painnick/BB8-2/body_mcu/README.md

# Body

## PCB

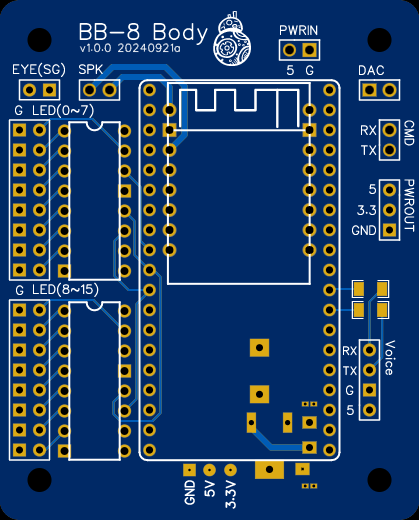
[picture p1: body_mcu/doc/body_mcu_top.png]


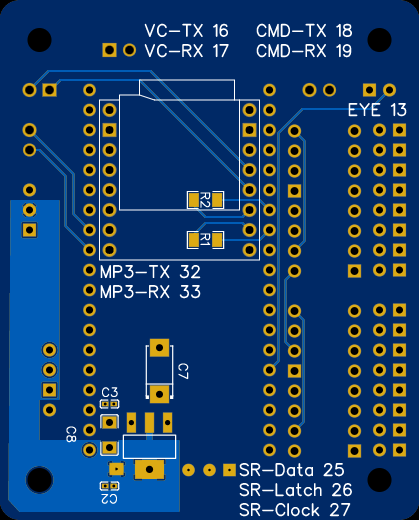
[picture p2: body_mcu/doc/body_mcu_bottom.png]


## Schematic

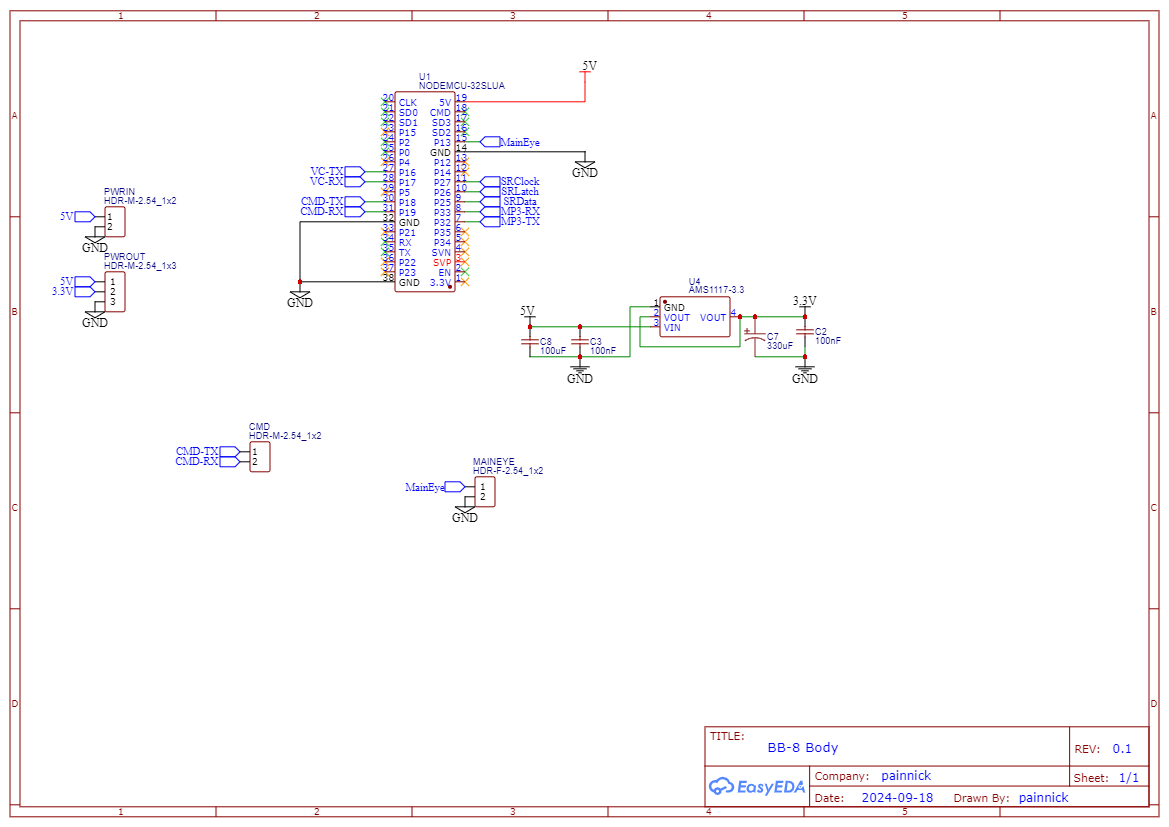
[picture p3: body_mcu/doc/Main.png]


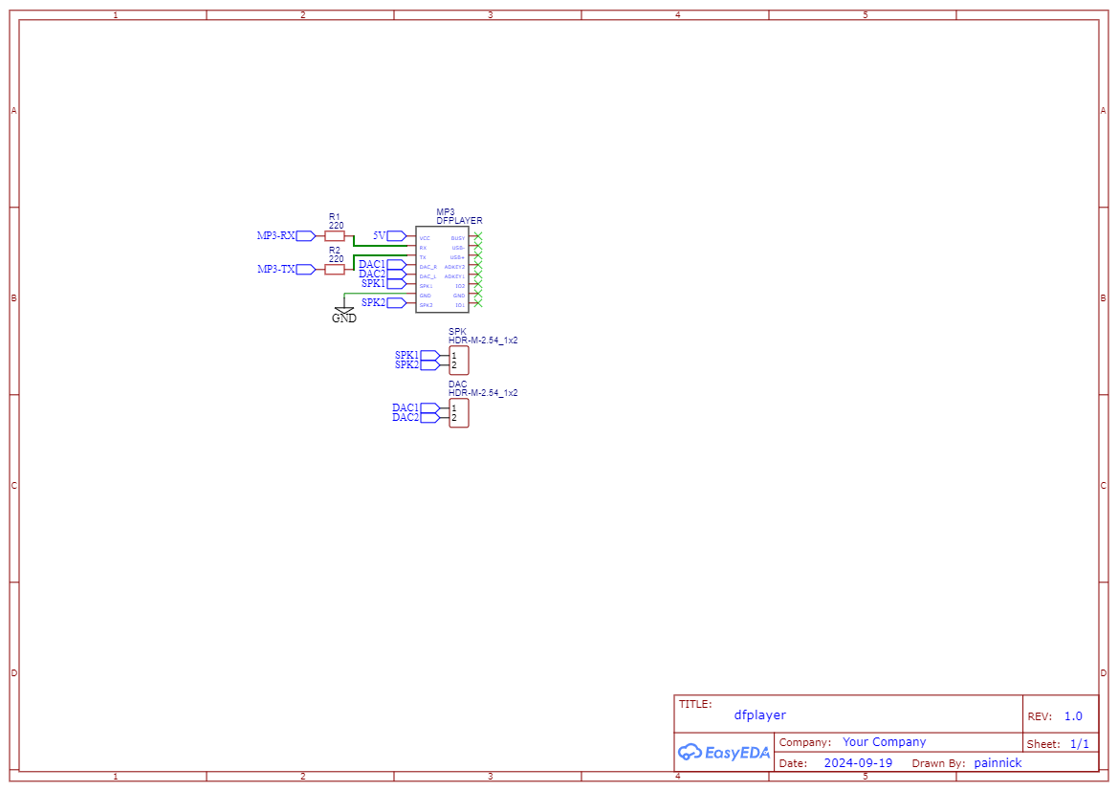
[picture p4: body_mcu/doc/dfplayer.png]


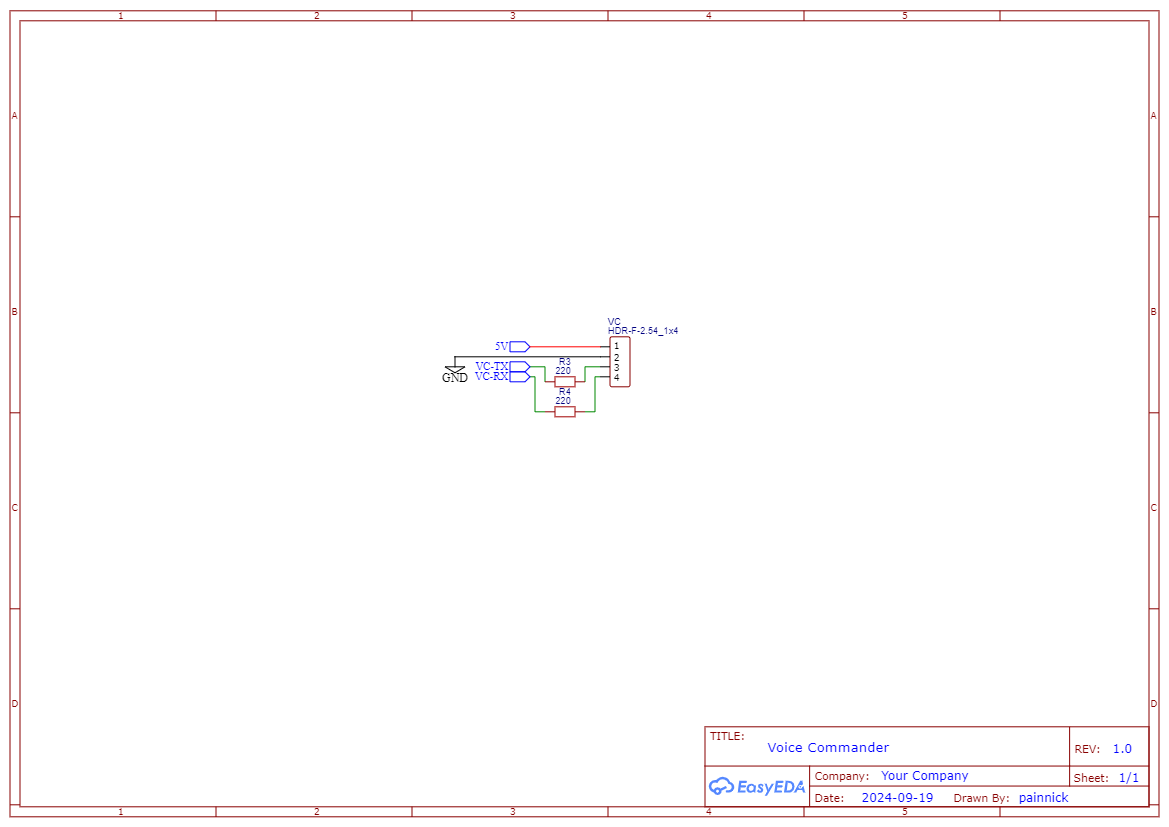
[picture p5: body_mcu/doc/VoiceCommander.png]
Voice Commander.png


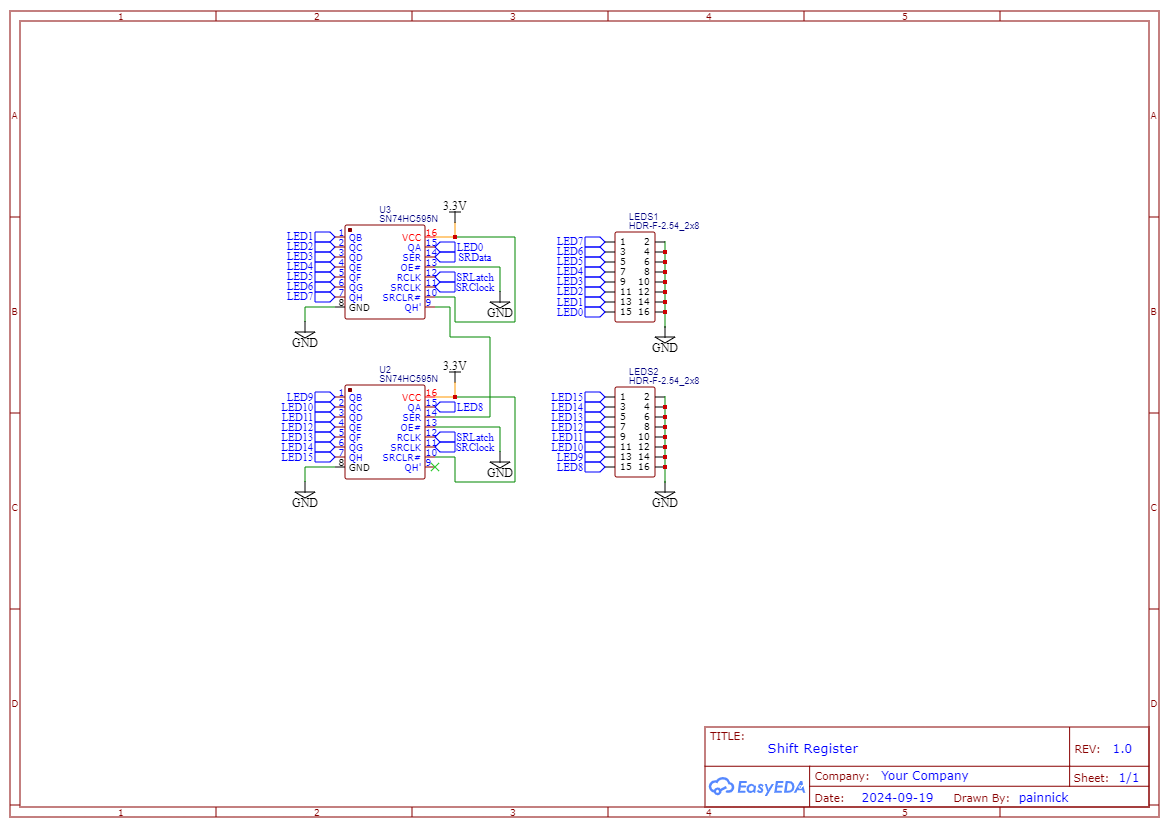
[picture p6: body_mcu/doc/ShiftRegister.png]
Shift Register.png
