painnick/BB8-2/head_mcu/README.md

# Head

## PCB

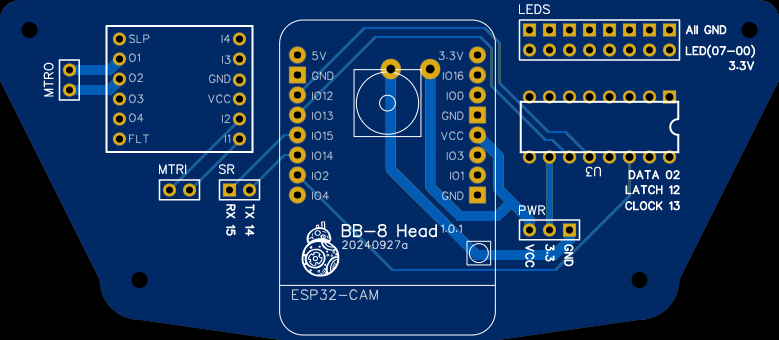
[picture p7: head_mcu/doc/head_mcu_top.png]


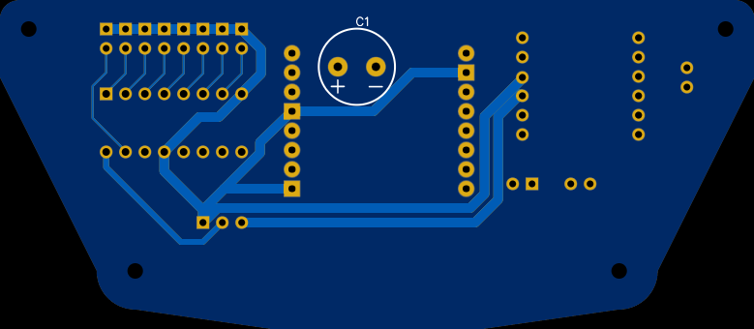
[picture p8: head_mcu/doc/head_mcu_bottom.png]


## Schematic

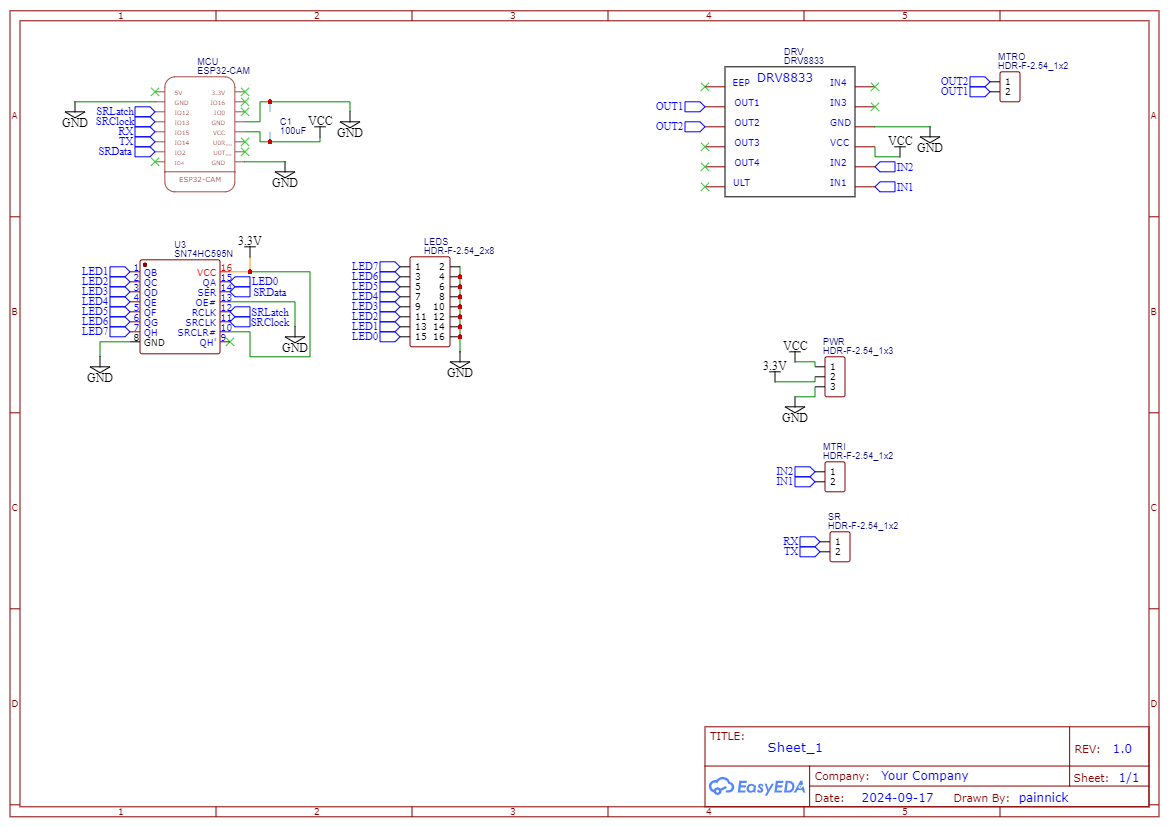
[picture p9: head_mcu/doc/Schematic_BB-8-Head_2024-09-28.png]
