painnick/BB8-2/3dp/PCB - Body.step

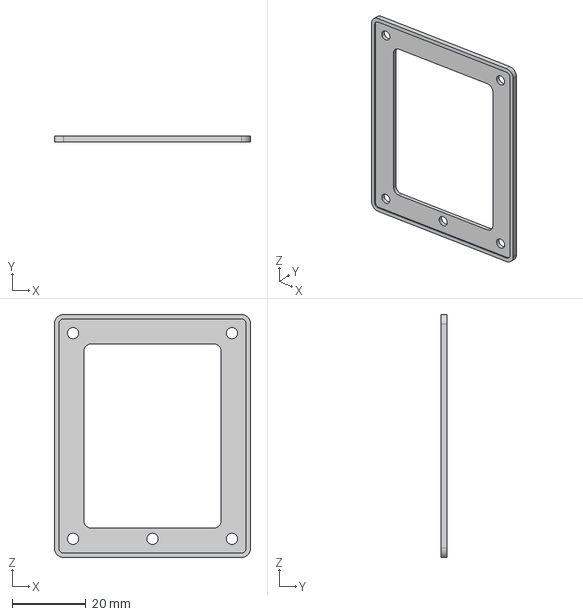
[picture p11: CAD file, 2026-06-03]
3dp/PCB - Body.step
53.3 x 1.60 x 66.0 mm
