painnick/BB8-2/3dp/LED Holder.step

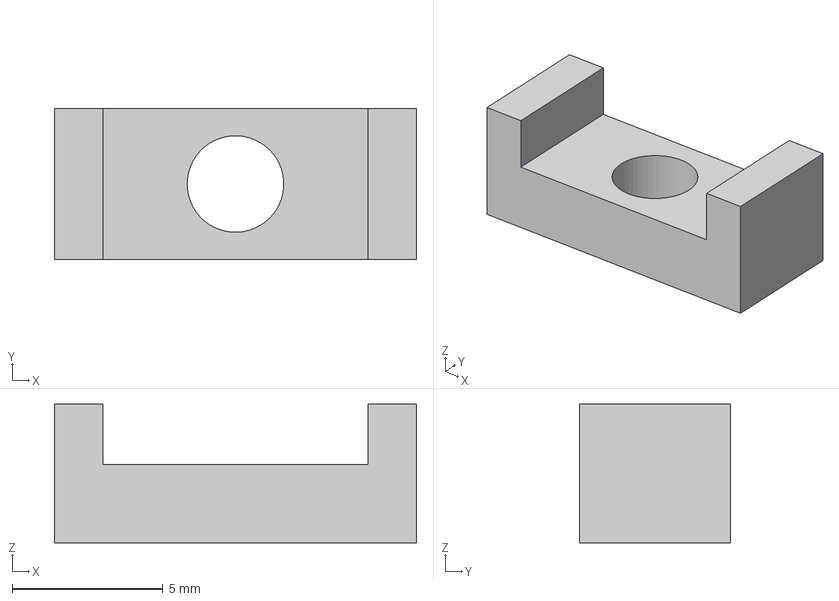
[picture p12: CAD file, 2026-06-03]
3dp/LED Holder.step
12.0 x 5.00 x 4.60 mm
