painnick/BB8-2/3dp/Motor Guide.step

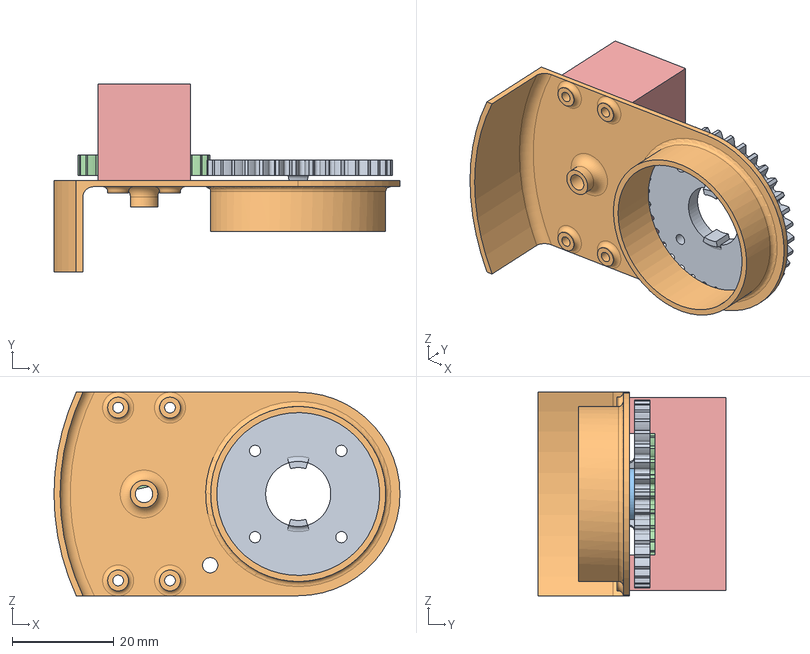
[picture p13: CAD file, 2026-06-03]
3dp/Motor Guide.step
68.0 x 37.0 x 40.0 mm
Spur Gear (35 teeth)
Base
Ring
Spur Gear (24 teeth)
MotorGuide
