painnick/BB8-2/(list of files, drawings)

Other design files:
BB-8 Sketch.fzz
