painnick/BB8-2/head_mcu/ShiftRegisterController.cpp

#include "ShiftRegisterController.h"

#include "esp_log.h"
#include <Arduino.h>
#include <CircularBuffer.hpp>

#include "pins.h"

#define SR_TAG "SR"

#define RANDOM_INTERVAL_MS 300

ShiftRegisterMode mode{FIXED};
ShiftRegisterMode lastMode{FIXED};
byte value1;
byte lastValue1{};
bool changed = false;
unsigned long lastChecked{};
int lastActionIndex = 0;
int runningActionIndex = 0;

CircularBuffer<SR_ACTION, 10> actions;

void internalSet(byte val1) {
  digitalWrite(SR_LATCH_PIN, LOW);
  shiftOut(SR_DATA_PIN, SR_CLOCK_PIN, MSBFIRST, val1);
  digitalWrite(SR_LATCH_PIN, HIGH);

  ESP_LOGD(SR_TAG, "%02X", val1);
}

void initShiftRegister() {
  pinMode(SR_DATA_PIN, OUTPUT);
  pinMode(SR_LATCH_PIN, OUTPUT);
  pinMode(SR_CLOCK_PIN, OUTPUT);
}

bool loopShiftRegister(unsigned long now, bool forceUpdate) {
  bool isLastAction = false;
  switch (mode) {
    case ShiftRegisterMode::FIXED: {
      if (forceUpdate || changed) {
        ESP_LOGD(SR_TAG, "FIXED. Changed");
        internalSet(value1);
        changed = false;
      }
      isLastAction = true;
      break;
    }
    case ShiftRegisterMode::ACTIONS: {
      SR_ACTION firstAction = actions.first();
      if (now < firstAction.endMs) {
        if (firstAction.idx != runningActionIndex) {
          ESP_LOGD(SR_TAG, "Do First Action");
          runningActionIndex = firstAction.idx;
          internalSet(firstAction.val1);
        }
      } else if (firstAction.endMs < now) {
        ESP_LOGD(SR_TAG, "End First Action. And shift.");
        actions.shift();

        if (!actions.isEmpty()) {
          ESP_LOGD(SR_TAG, "Do Next Action");
          SR_ACTION newAction = actions.first();
          runningActionIndex = newAction.idx;
          internalSet(newAction.val1);
        }
      }
      break;
    }
    case ShiftRegisterMode::RANDOM: {
      if (now - lastChecked > RANDOM_INTERVAL_MS) {
        internalSet(random(256));
        lastChecked = now;
      }
      break;
    }
    default:
      ESP_LOGW(SR_TAG, "Unhandled Mode!");
      break;
  }

  return isLastAction;
}

void setShiftRegister(byte newVal1) {
  actions.clear();

  mode = ShiftRegisterMode::FIXED;

  changed = (value1 != newVal1);

  value1 = newVal1;
}

void shiftRegisterOn(int index) {
  actions.clear();

  mode = ShiftRegisterMode::FIXED;

  byte newVal1 = value1;
  bitSet(newVal1, index);
  changed = (value1 != newVal1);
  value1 = newVal1;
}

void shiftRegisterOff(int index) {
  actions.clear();

  mode = ShiftRegisterMode::FIXED;

  byte newVal1 = value1;
  bitClear(newVal1, index);
  changed = (value1 != newVal1);
  value1 = newVal1;
}

void clearShiftRegister(bool fixed) {
  if (fixed)
    mode = ShiftRegisterMode::FIXED;

  value1 = 0;
  changed = true;
}

void appendShiftRegisterAction(SR_ACTION action) {
  lastActionIndex = (lastActionIndex + 1) % 100;
  action.idx = lastActionIndex;

  mode = ShiftRegisterMode::ACTIONS;

  if (actions.isEmpty()) {
    ESP_LOGD(SR_TAG, "Add First Action! %ul %02X", action.endMs, action.val1);
    actions.push(action);
    internalSet(action.val1);
  } else if (actions.isFull()) {

    ESP_LOGW(SR_TAG, "Action queue is FULL!");

  } else {
    SR_ACTION lastAction = actions.last();
    if (lastAction.endMs >= action.endMs) {

      ESP_LOGW(SR_TAG, "The previous request ends later!");

    } else {
      actions.push(action);

      ESP_LOGD(SR_TAG, "Add new Action %ul %02x", action.endMs, action.val1);
    }
  }
}

byte getShiftRegisterValue() { return value1; }

void warningMessage() {
  unsigned long now = millis();

  mode = ShiftRegisterMode::ACTIONS;

  appendShiftRegisterAction({.endMs = now + 200, .val1 = 0xFF});
  appendShiftRegisterAction({.endMs = now + 400, .val1 = 0x00});
  appendShiftRegisterAction({.endMs = now + 600, .val1 = 0xFF});
  appendShiftRegisterAction({.endMs = now + 800, .val1 = 0x00});
  appendShiftRegisterAction({.endMs = now + 1000, .val1 = 0xFF});
  appendShiftRegisterAction({.endMs = now + 1200, .val1 = 0x00});
}

void randomLight(boolean isOn) {
  actions.clear();

  if (isOn) {
    lastMode = mode;
    lastValue1 = value1;
    mode = ShiftRegisterMode::RANDOM;
  } else {
    if (mode == ShiftRegisterMode::RANDOM) {
      mode = lastMode;
      value1 = lastValue1;
      changed = true;
    }
  }
}
