painnick/BB8-2/(commit log)

2024-09-28 FIX. Command Value Duplication
    [VoiceCommander.h]
2024-09-28 UPDATE. Bluetooth println
2024-09-28 UPDATE. Intermittent loudness issues
    [main.cpp]
2024-09-28 Revert "UPDATE. Wake up vc-02"
    This reverts commit e43598f6d123d120efa224ecd76b6a5d411ff7de.
    [VoiceCommander.cpp, VoiceCommander.h, main.cpp]
2024-09-30 REFACTORING. pin
2024-09-30 REFACTORING. Camera
2024-09-30 RENAME. camera_control
2024-09-30 ADD. WIFI Led
2024-09-30 UPDATE. WIFI Led
2024-09-30 FIX. Shift Register loop
    [ShiftRegisterController.cpp, ShiftRegisterController.h]
2024-10-01 ADD. Motor Controller
2024-10-01 BUGFIX. Wrong Buffer time condition
    [command_router.cpp]
2024-10-01 LOG. Disable LED log
2024-10-01 FIX. Disable Brown out
    [head_mcu.ino]
2024-10-01 FIX. HTTP Left/Right req
    [app_httpd.cpp]
2024-10-02 UPDATE. Change mp3 & Send sleep uart data
2024-10-03 FIX. Useless Head movement
    [main.cpp]
2024-10-03 ADD. State LED
2024-10-04 ADD. uart recv callback
2024-10-05 FIX. Motor Action(Fool)
2024-10-05 UPDATE. Motor Action(WakeUp)
2024-10-05 FIX. SR LED Action
    [ShiftRegisterController.cpp, ShiftRegisterController.h, main.cpp]
2024-10-06 REMOVE. Not a BUG
    [hb_auto_gpio.c]
2024-10-06 BUGFIX. Head movement and running time
    [main.cpp]
2024-10-06 FIX. SR LED Off on Boot
    [head_mcu.ino, main.cpp]
2024-10-06 FIX. SR LED
2024-10-10 UPDATE. Face track
2024-10-10 ADD. Sketch
    [BB-8 Sketch.fzz]
2024-10-29 ADD. Close button
2026-06-03 ADD. 3d prints
2026-06-08 CHANGE. DISABLE_MP3_DEBUG_LOG 선언 처리
2026-06-08 UPDATE. 볼륨값들을 EEPROM에 저장
